HeyPCB/quack-core/cad/fit_section.png

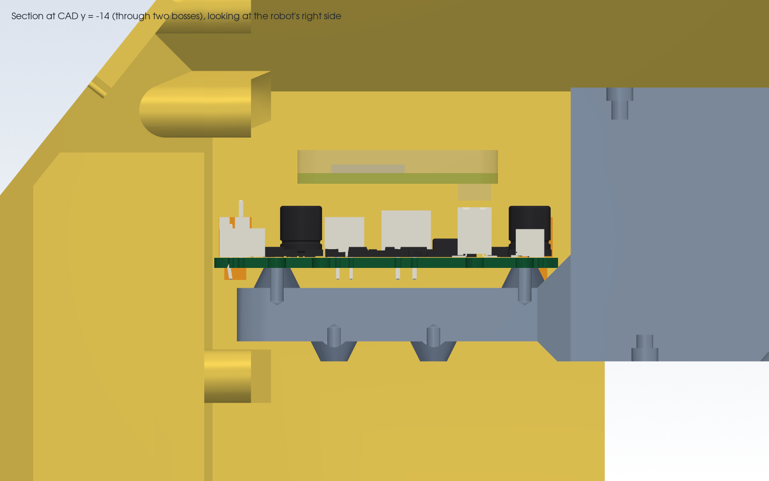
cad/fit_section.png
