HeyPCB/quack-core/cad/fit_top.png

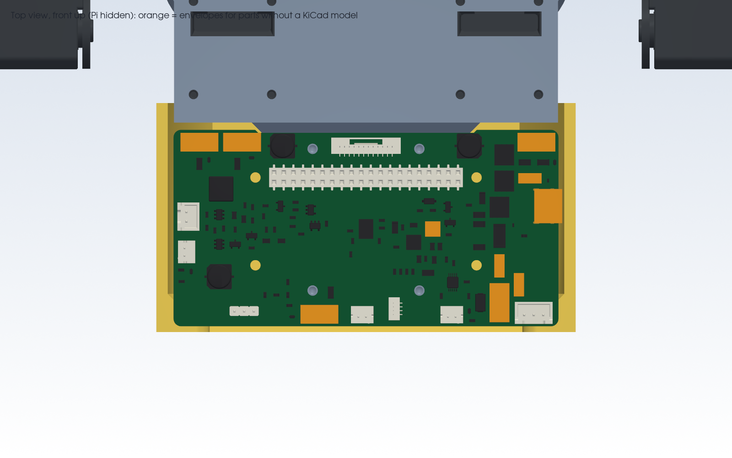
cad/fit_top.png
