HeyPCB/quack-core/cad/fit_usbc.png

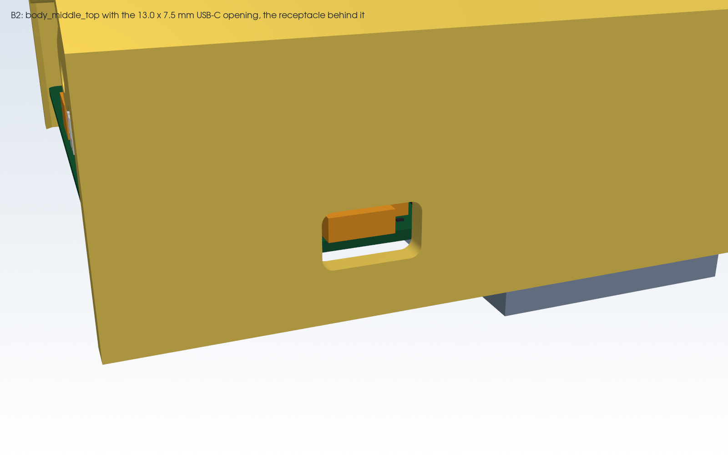
cad/fit_usbc.png
