HeyPCB/quack-core/media/bottom.png

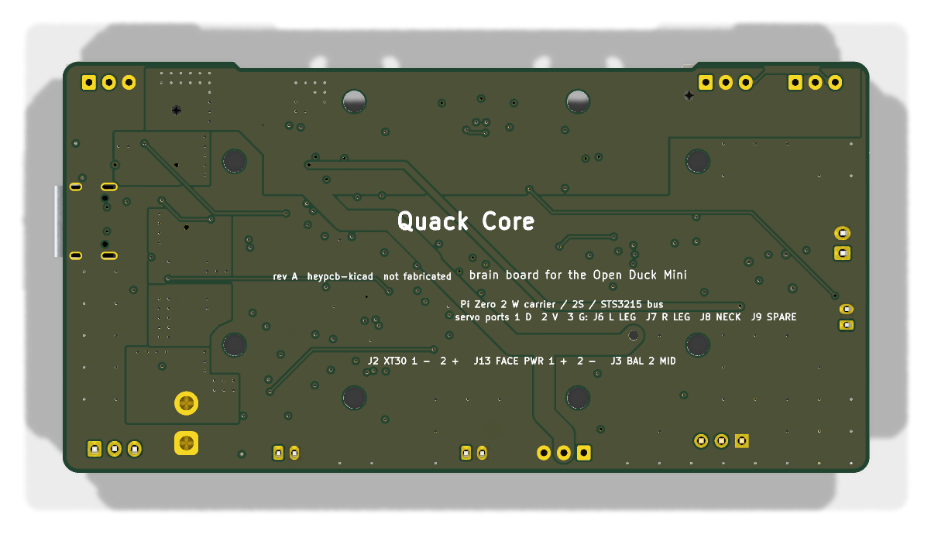
media/bottom.png
