HeyPCB/quack-core/media/top.png

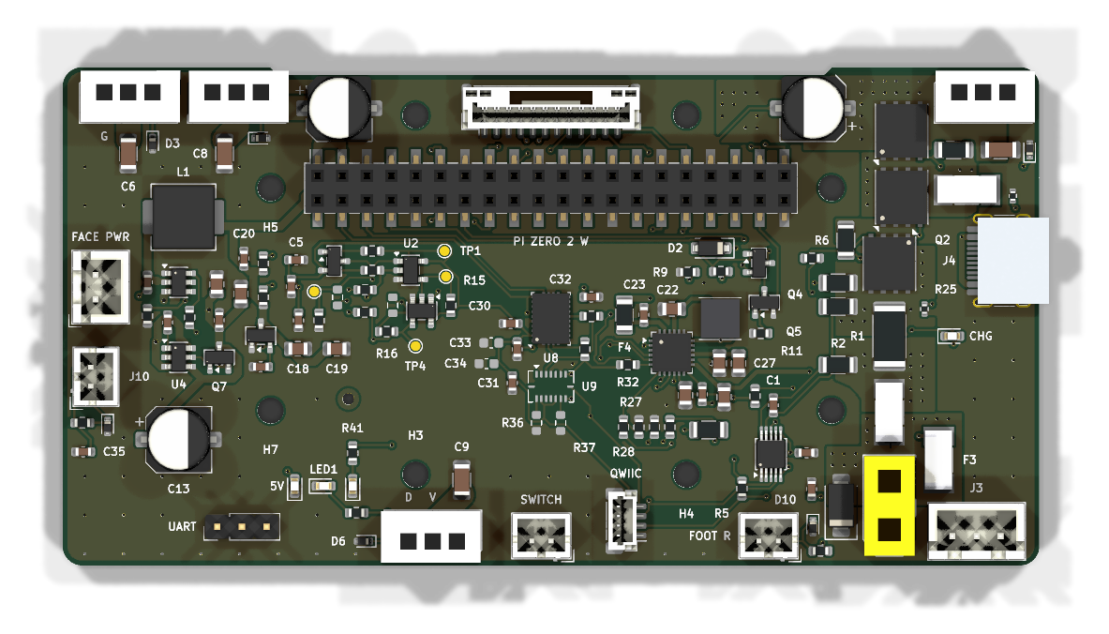
media/top.png
