HeyPCB/quack-core/fab/quack_core_bom.csv

Reference | Value | Footprint | MPN | LCSC | Qty
C1,C2,C3,C4,C12,C16,C17,C29,C30,C35,C36 | 100nF | Capacitor_SMD:C_0603_1608Metric | CC0603KRX7R9BB104 | C14663 | 11
C5,C20,C21,C22,C32 | 1uF | Capacitor_SMD:C_0603_1608Metric | CL10A105KB8NNNC | C15849 | 5
C6,C7,C8,C9 | 10uF | Capacitor_SMD:C_1206_3216Metric | CL31A106KBHNNNE | C13585 | 4
C10,C11,C13 | 470uF 16V | Capacitor_SMD:CP_Elec_6.3x7.7 | RVT1C471M0607 | C2977552 | 3
C14,C15,C28 | 10uF | Capacitor_SMD:C_0805_2012Metric | CL21A106KAYNNNE | C15850 | 3
C18,C19,C23,C26,C27 | 22uF | Capacitor_SMD:C_0805_2012Metric | CL21A226MAQNNNE | C45783 | 5
C24 | 47nF | Capacitor_SMD:C_0603_1608Metric | CL10B473KB8NNNC | C1622 | 1
C25 | 4.7uF | Capacitor_SMD:C_0805_2012Metric | CL21A475KAQNNNE | C1779 | 1
C31 | 22nF | Capacitor_SMD:C_0603_1608Metric | CL10B223KB8NNNC | C21122 | 1
D1 | SMAJ10CA | Diode_SMD:D_SMA | SMAJ10CA | C19077530 | 1
D2 | B5819W | Diode_SMD:D_SOD-123 | B5819W SL | C8598 | 1
D3,D4,D5,D6,D9,D10 | ESD5Z5.0 | Diode_SMD:D_SOD-523 | ESD5Z5.0T1G | C82044 | 6
D7 | Green (5V) | LED_SMD:LED_0603_1608Metric | KT-0603G | C12624 | 1
D8 | Orange (CHG) | LED_SMD:LED_0603_1608Metric | XL-1608UOC-06 | C965800 | 1
D11 | Red (LED1) | LED_SMD:LED_0603_1608Metric | KT-0603R | C2286 | 1
D12 | Red (LED2) | LED_SMD:LED_0603_1608Metric | KT-0603R | C2286 | 1
F1 | 20A | Fuse:Fuse_Littelfuse-NANO2-451_453 | 0451020.MRL | C178980 | 1
F2,F3 | 5A | Fuse:Fuse_Littelfuse-NANO2-451_453 | 0451005.MRL | C48467 | 2
F4 | 2A PTC | Fuse:Fuse_1206_3216Metric | 1206L200/16NR | C22374899 | 1
J1 | Pi Zero 2 W | Connector_PinSocket_2.54mm:PinSocket_2x20_P2.54mm_Vertical_SMD | PM254-2-20-S-8.5 | C3975165 | 1
J2 | XT30 BATT | Connector_AMASS:AMASS_XT30UPB-M_1x02_P5.0mm_Vertical | XT30UPB-M | C428721 | 1
J3 | BALANCE | Connector_JST:JST_XH_B3B-XH-A_1x03_P2.50mm_Vertical | B3B-XH-A(LF)(SN) | C144394 | 1
J4 | USB-C CHARGE | Connector_USB:USB_C_Receptacle_HRO_TYPE-C-31-M-12 | TYPE-C-31-M-12 | C165948 | 1
J5 | SWITCH | Connector_JST:JST_PH_B2B-PH-K_1x02_P2.00mm_Vertical | B2B-PH-K-S(LF)(SN) | C131337 | 1
J6,J7,J8,J9 | SERVO | Connector_Molex:Molex_SPOX_5267-03A_1x03_P2.50mm_Vertical | HC-5264-3A | C2845815 | 4
J10,J11 | FOOT | Connector_JST:JST_PH_B2B-PH-K_1x02_P2.00mm_Vertical | B2B-PH-K-S(LF)(SN) | C131337 | 2
J12 | FACE | Connector_JST:JST_GH_BM12B-GHS-TBT_1x12-1MP_P1.25mm_Vertical | BM12B-GHS-TBT(LF)(SN)(N) | C2983891 | 1
J13 | FACE PWR | Connector_JST:JST_XH_B2B-XH-A_1x02_P2.50mm_Vertical | B2B-XH-A(LF)(SN) | C158012 | 1
J14 | QWIIC | Connector_JST:JST_SH_BM04B-SRSS-TB_1x04-1MP_P1.00mm_Vertical | BM04B-SRSS-TB(LF)(SN) | C160390 | 1
J16 | UART | Connector_PinHeader_2.54mm:PinHeader_1x03_P2.54mm_Vertical | PZ254V-11-03P | C2937625 | 1
L1 | 5.6uH | Inductor_SMD:L_Changjiang_FXL0630 | FXL0630-5R6-M | C475914 | 1
L2 | 1uH | Inductor_SMD:L_Coilcraft_XxL4020 | XFL4020-102MEC | C5355380 | 1
Q1,Q2,Q3 | AON6411 | Package_DFN_QFN:AO_DFN-8-1EP_5.55x5.2mm_P1.27mm_EP4.12x4.6mm | AON6411 | C81007 | 3
Q4,Q5,Q7 | AO3400A | Package_TO_SOT_SMD:SOT-23 | AO3400A | C20917 | 3
Q6 | MMBT3906 | Package_TO_SOT_SMD:SOT-23 | MMBT3906LT1G | C53444 | 1
R1 | 1mΩ 3W | Resistor_SMD:R_2512_6332Metric | HoJLR2512-3W-1mR-1% | C2903470 | 1
R2,R3,R4 | 10 | Resistor_SMD:R_1206_3216Metric | 1206W4F100JT5E | C17903 | 3
R5,R7,R9,R12,R13,R15,R16,R23,R28,R32,R34,R35 | 10k | Resistor_SMD:R_0603_1608Metric | FRC0603F1002TS | C2906982 | 12
R6,R8 | 100k | Resistor_SMD:R_1206_3216Metric | 1206W4F1003T5E | C17900 | 2
R10,R11 | 100k | Resistor_SMD:R_0603_1608Metric | 0603WAF1003T5E | C25803 | 2
R14 | 20k | Resistor_SMD:R_0603_1608Metric | 0603WAF2002T5E | C4184 | 1
R17,R18 | 0 | Resistor_SMD:R_0603_1608Metric | 0603WAF0000T5E | C21189 | 2
R21 | 33 | Resistor_SMD:R_0603_1608Metric | 0603WAF330JT5E | C23140 | 1
R22 | 53.6k | Resistor_SMD:R_0603_1608Metric | FRC0603F5362TS | C2930115 | 1
R24,R33 | 2.2k | Resistor_SMD:R_0603_1608Metric | 0603WAF2201T5E | C4190 | 2
R25,R26 | 5.1k | Resistor_SMD:R_0402_1005Metric | 0402WGF5101TCE | C25905 | 2
R27 | 750 | Resistor_SMD:R_0603_1608Metric | 0603WAF7500T5E | C23241 | 1
R29 | 12.4k | Resistor_SMD:R_0603_1608Metric | FRC0603F1242TS | C2930060 | 1
R30 | 330 | Resistor_SMD:R_0603_1608Metric | 0603WAF3300T5E | C23138 | 1
R31 | 100 | Resistor_SMD:R_1206_3216Metric | 1206W4F1000T5E | C17901 | 1
R38,R39,R40,R41 | 1k | Resistor_SMD:R_0603_1608Metric | 0603WAF1001T5E | C21190 | 4
U1 | INA226 | Package_SO:TSSOP-10_3x3mm_P0.5mm | INA226AIDGSR | C49851 | 1
U2 | 74LVC1G126 | Package_TO_SOT_SMD:SOT-23-5 | SN74LVC1G126DBVR | C7834 | 1
U3 | 74LVC1G125 | Package_TO_SOT_SMD:SOT-23-5 | SN74LVC1G125DBVR | C23654 | 1
U4 | LM74700-Q1 | Package_TO_SOT_SMD:SOT-23-6 | LM74700QDBVRQ1 | C2941042 | 1
U5 | TPS56339 | Package_TO_SOT_SMD:SOT-23-6 | TPS56339DDCR | C2071106 | 1
U6 | XC6206P332 | Package_TO_SOT_SMD:SOT-23-3 | XC6206P332MR-G | C5446 | 1
U7 | BQ25887 | Package_DFN_QFN:Texas_RGE0024H_VQFN-24-1EP_4x4mm_P0.5mm_EP2.7x2.7mm | BQ25887RGER | C2761614 | 1
U8 | BNO055 | Package_LGA:LGA-28_5.2x3.8mm_P0.5mm | BNO055 | C93216 | 1
