HeyPCB/quack-core/cad/body_middle_top_usbc.step

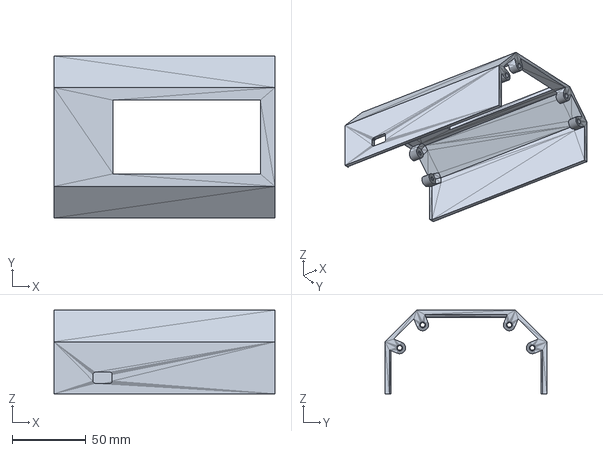
[picture p9: CAD file, 2026-10-03]
cad/body_middle_top_usbc.step
150.0 x 110.0 x 56.8 mm
