HeyPCB/quack-core/fab/quack_core.step

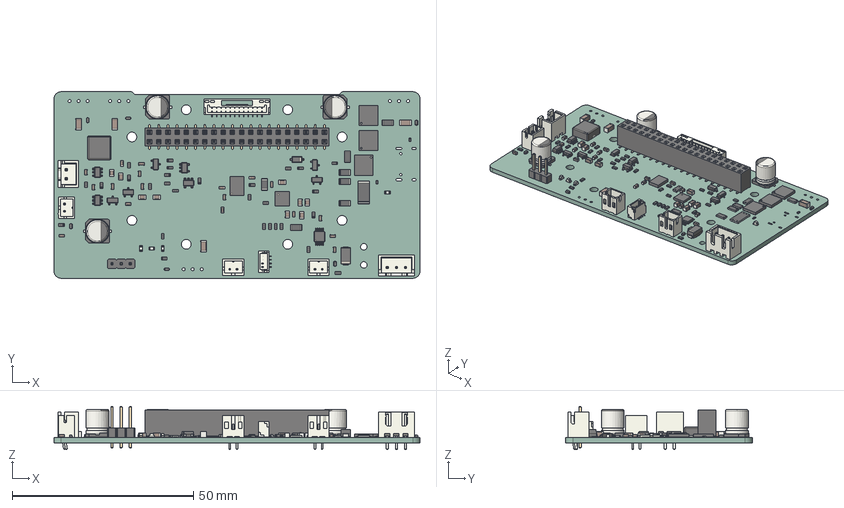
[picture p10: CAD file, 2026-10-03]
fab/quack_core.step
101.0 x 51.5 x 11.9 mm
C_1206_3216Metric x 4
JST_B2B_PH_K x 3
C_0603_1608Metric x 18
R_0603_1608Metric x 28
C_0805_2012Metric x 9
R_1206_3216Metric x 6
SOT-23 x 4
Texas_RGE0024H_VQFN-24-1EP_4x4mm_P0.5mm_EP2.7x2.7mm
LED_0603_1608Metric x 4
JST_BM12B_GHS_TBT
SOT-23-5 x 2
R_0402_1005Metric x 2
D_SOD_523 x 6
SOT-23-6 x 2
TSSOP-10_3x3mm_P0.5mm
Fuse_1206_3216Metric
PinHeader_1x03_P254mm_Vertical
CP_Elec_63x77 x 3
PinSocket_2x20_P2.54mm_Vertical_SMD
SOT-23-3
D_SOD-123
a4dc038a-92ba-11ed-bd60-83025610b399_part x 3
a4dc038b-92ba-11ed-bd60-83025610b399_part x 3
a4dc038c-92ba-11ed-bd60-83025610b399_part x 3
a4dc038d-92ba-11ed-bd60-83025610b399_part x 3
R_2512_6332Metric
JST_SH_BM04B-SRSS-TB_1x04-1MP_P1.00mm_Vertical
JST_B2B_XH_A
LGA_28_52x38mm_P05mm
D_SMA
JST_B3B_XH_A
L_Changjiang_FXL0630
quack_core_PCB
