HeyPCB/quack-core/(list of files, cad)

Other CAD files:
cad/body_middle_top_usbc.stl
