HeyPCB/quack-core/fab/quack_core_schematic.pdf

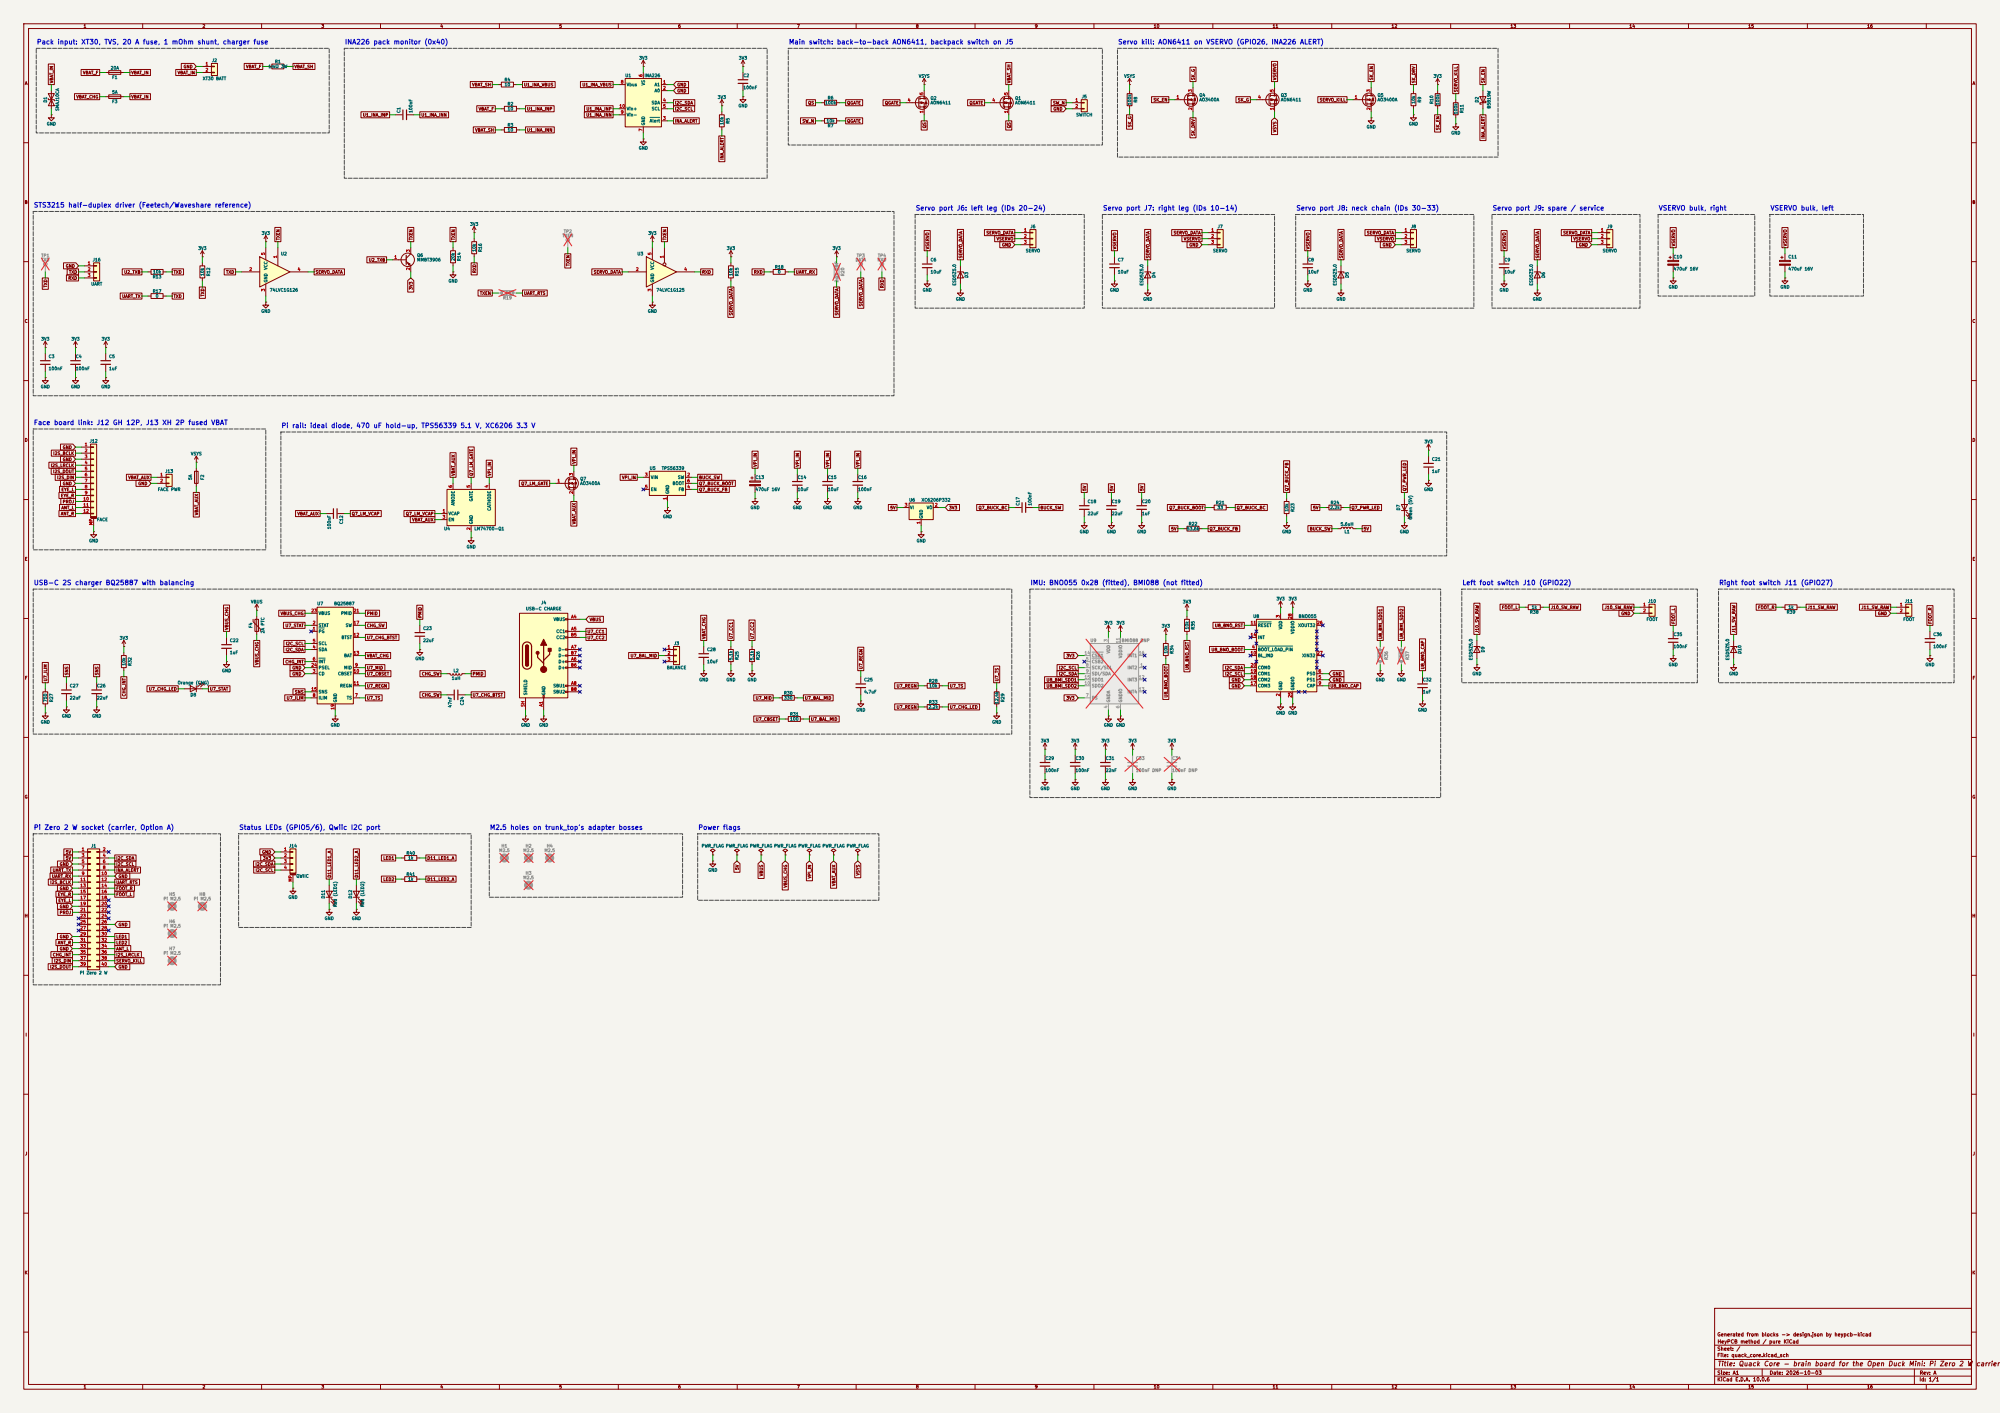
[picture p11: page 1]

Pack input: XT30, TVS, 20 A fuse, 1 mOhm shunt, charger fuse

Main switch: back-to-back AON6411, backpack switch on J5

Servo kill: AON6411 on VSERVO (GPIO26, INA226 ALERT)

STS3215 half-duplex driver (Feetech/Waveshare reference)

Servo port J6: left leg (IDs 20-24)

Servo port J9: spare / service

Face board link: J12 GH 12P, J13 XH 2P fused VBAT

Pi rail: ideal diode, 470 uF hold-up, TPS56339 5.1 V, XC6206 3.3 V

USB-C 2S charger BQ25887 with balancing

Pi Zero 2 W socket (carrier, Option A)
J1 Pi Zero 2 W

Status LEDs (GPIO5/6), Qwiic I2C port

M2.5 holes on trunk_top's adapter bosses

Generated from blocks -> design.json by heypcb-kicad
HeyPCB method / pure KiCad
Sheet: /
File: quack_core.kicad_sch
Title: Quack Core - brain board for the Open Duck Mini: Pi Zero 2 W carrier, 2S power path, STS3215 servo bus

Size: A1 | Rev: A
KiCad E.D.A. 10.0.6 | Id: 1/1
