HeyPCB/quack-core/kicad/quack_core.kicad_pcb

## KiCad design kicad/quack_core.kicad_pcb (2026-10-03)

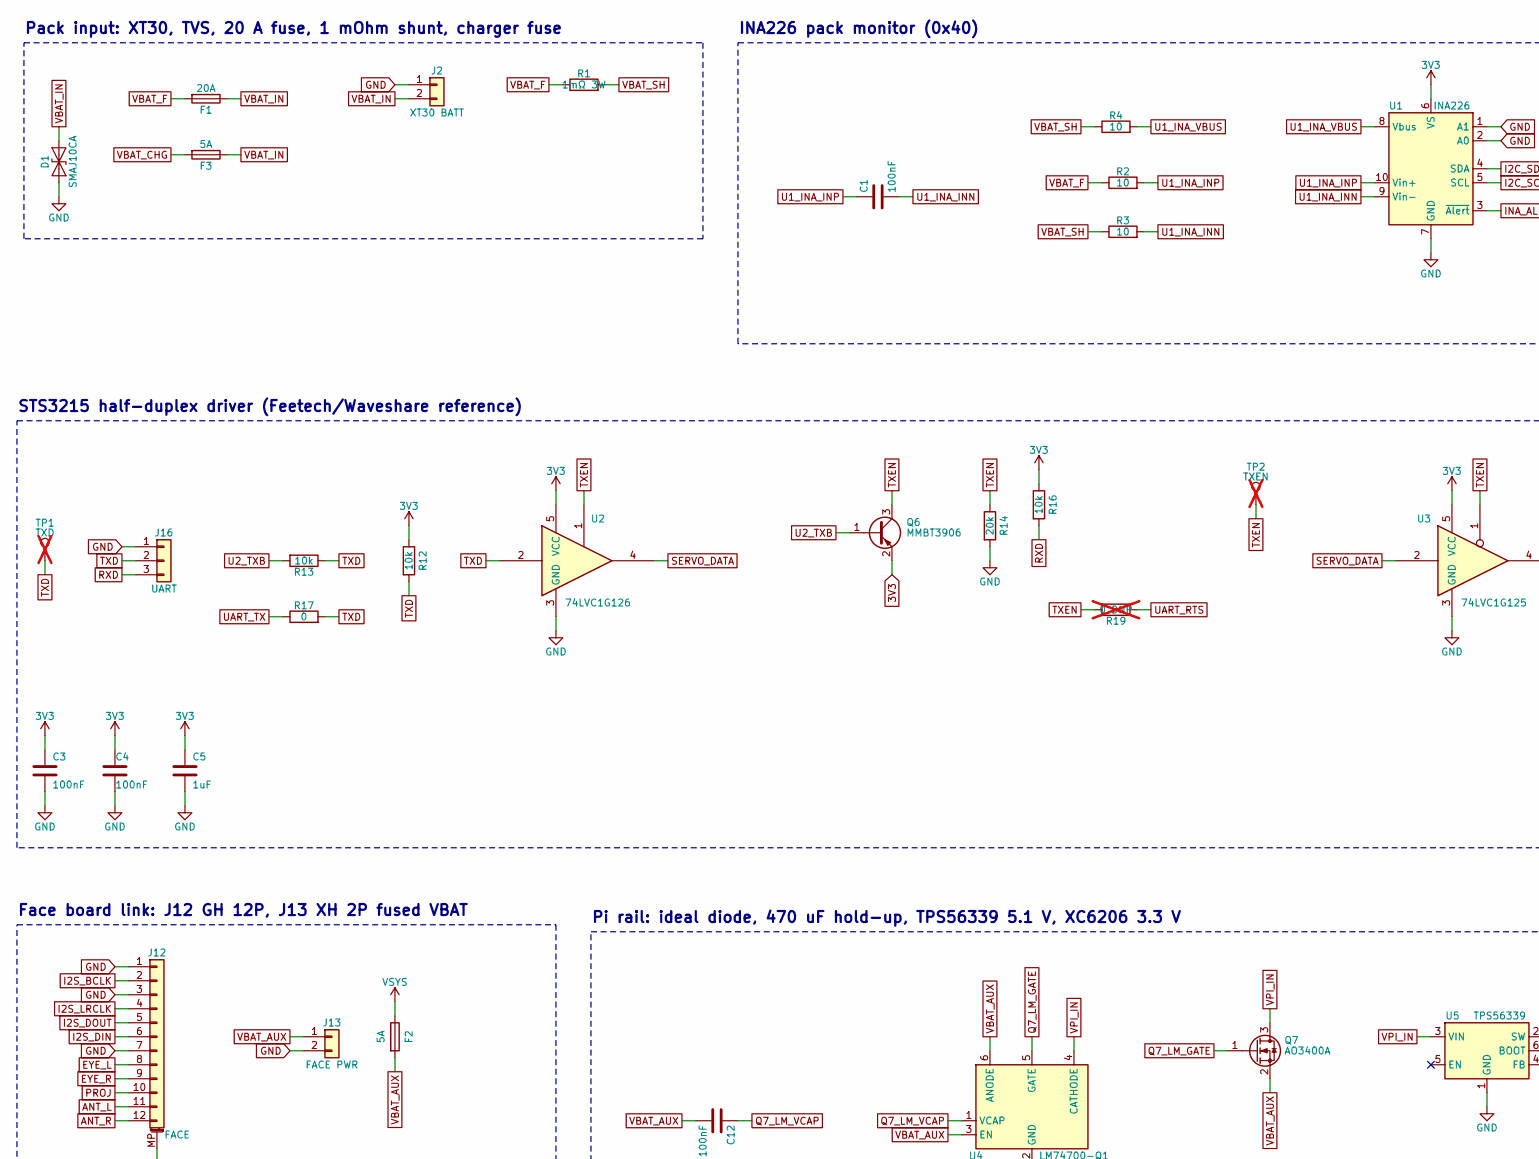
[picture p12: schematic quack_core.kicad_sch, Quack Core - brain board for the Open Duck Mini: Pi Zero 2 …, part in row 1, column 1]

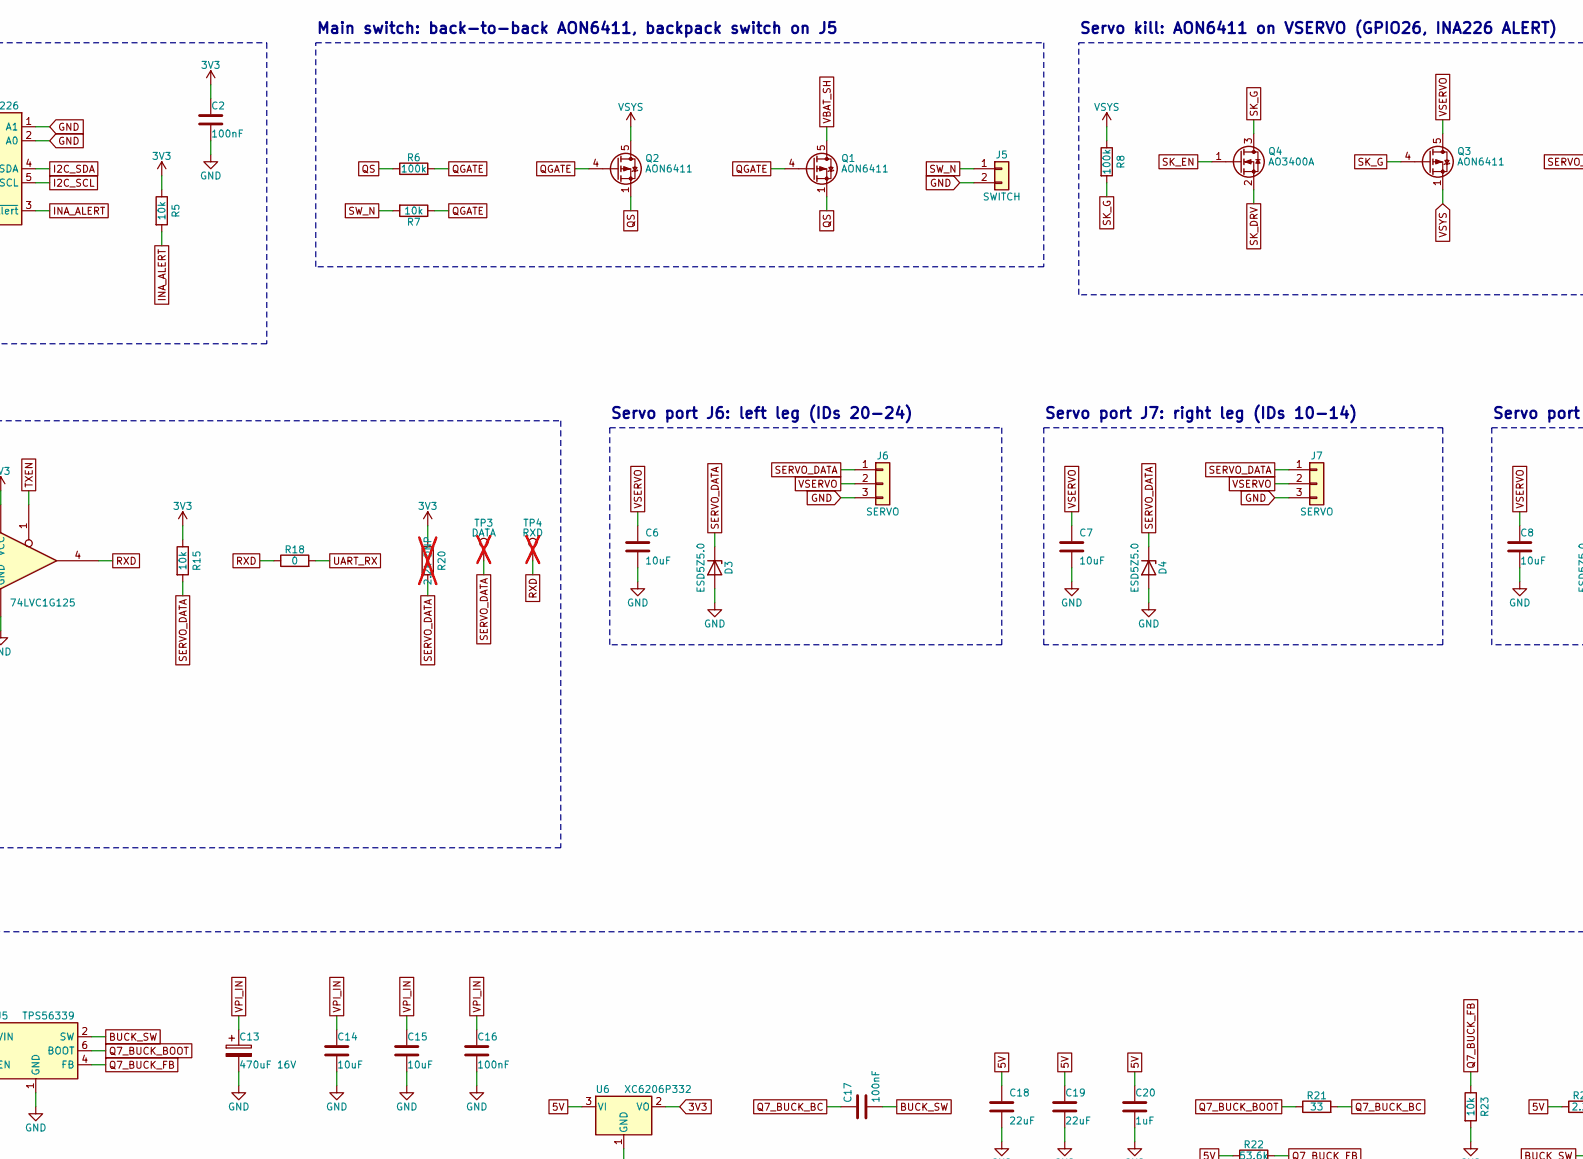
[picture p13: schematic quack_core.kicad_sch, Quack Core - brain board for the Open Duck Mini: Pi Zero 2 …, part in row 1, column 2]

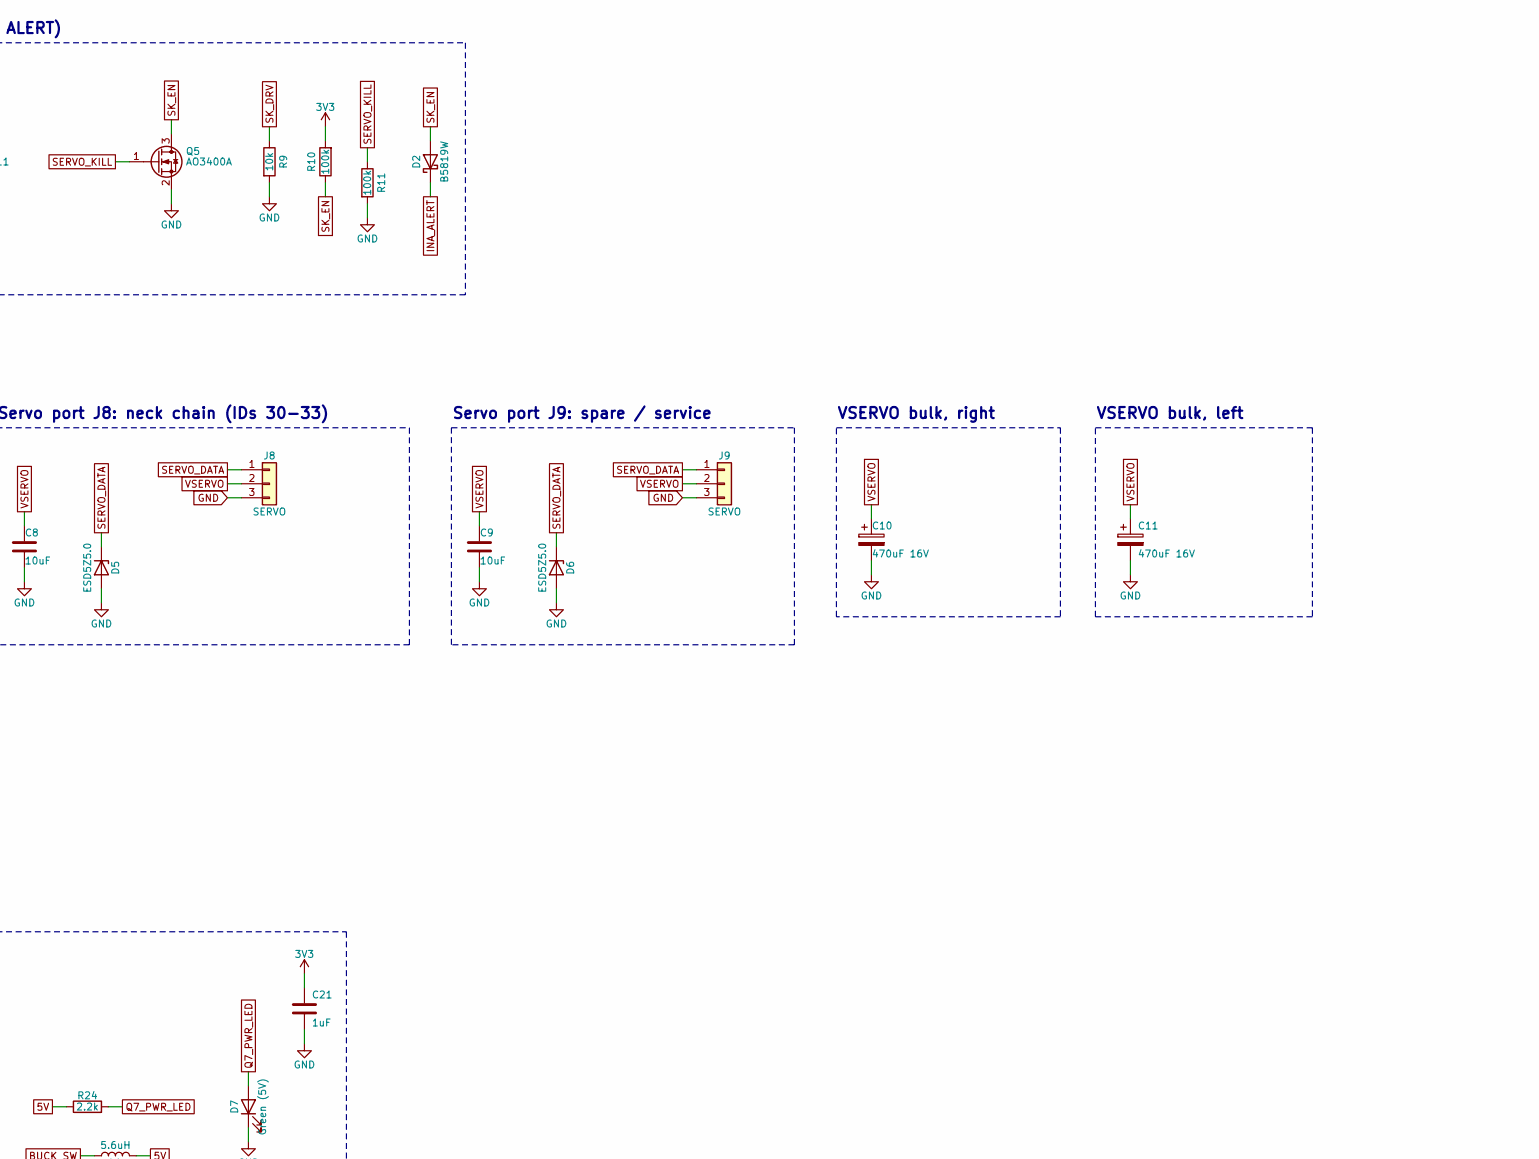
[picture p14: schematic quack_core.kicad_sch, Quack Core - brain board for the Open Duck Mini: Pi Zero 2 …, part in row 1, column 3]

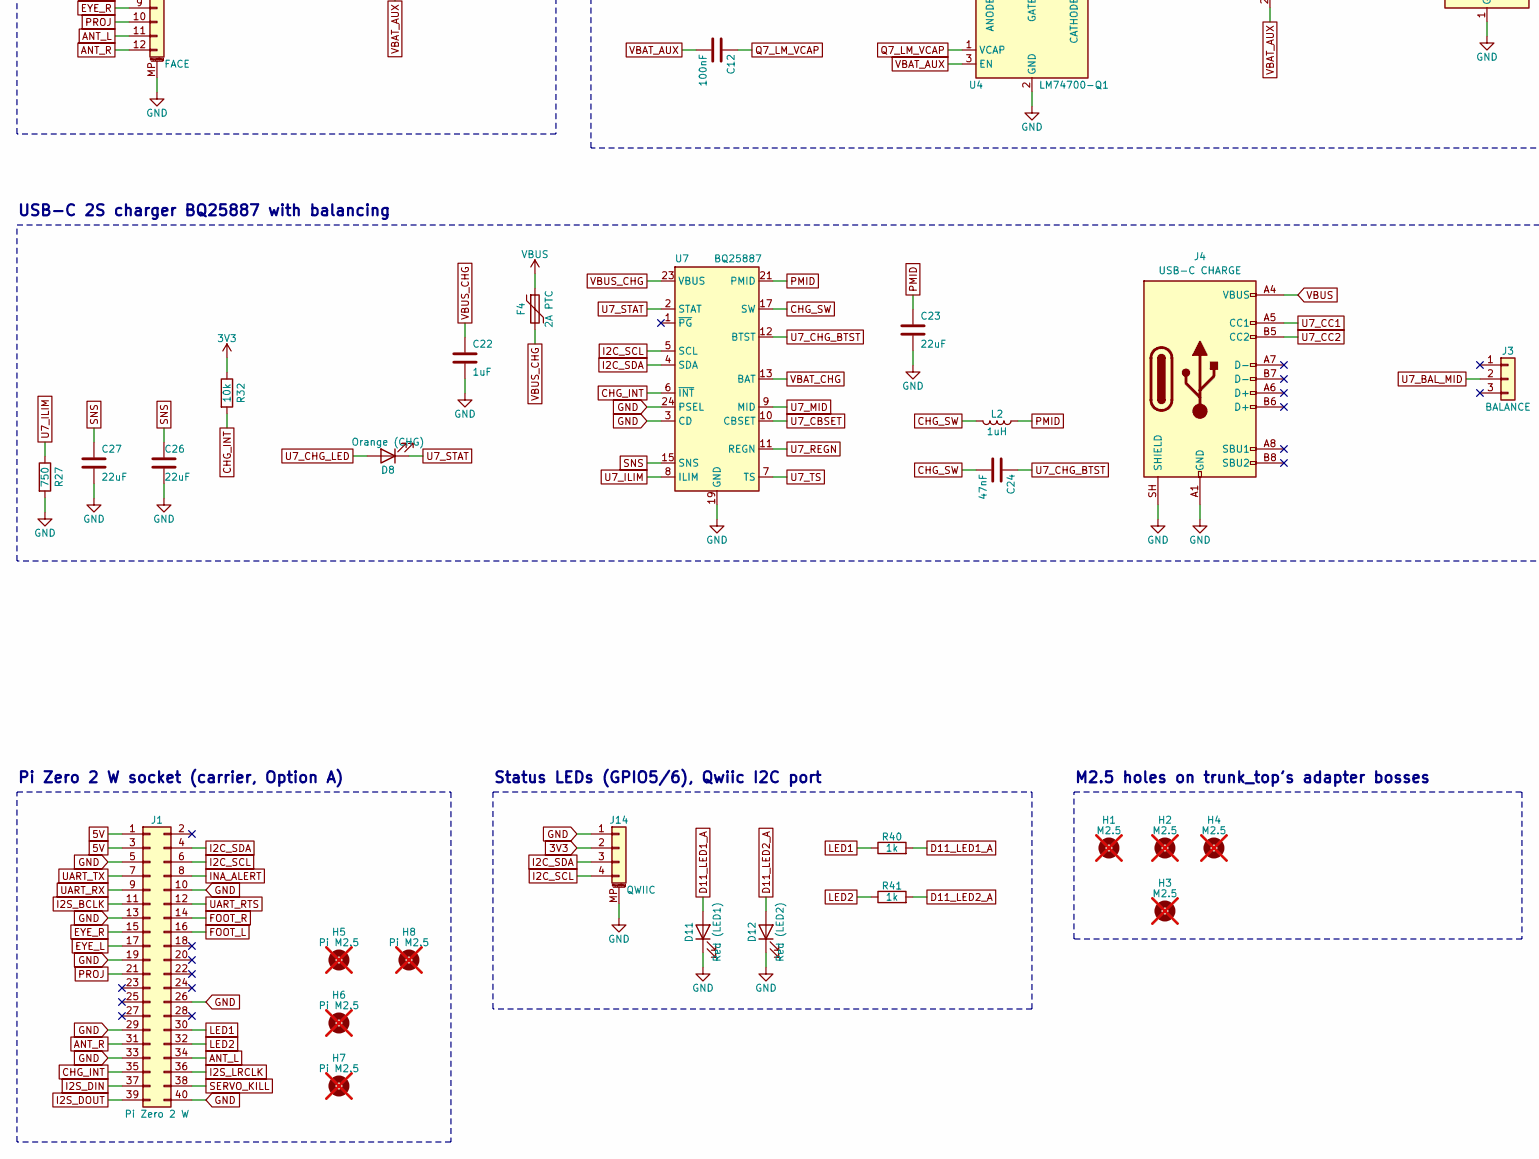
[picture p15: schematic quack_core.kicad_sch, Quack Core - brain board for the Open Duck Mini: Pi Zero 2 …, part in row 2, column 1]

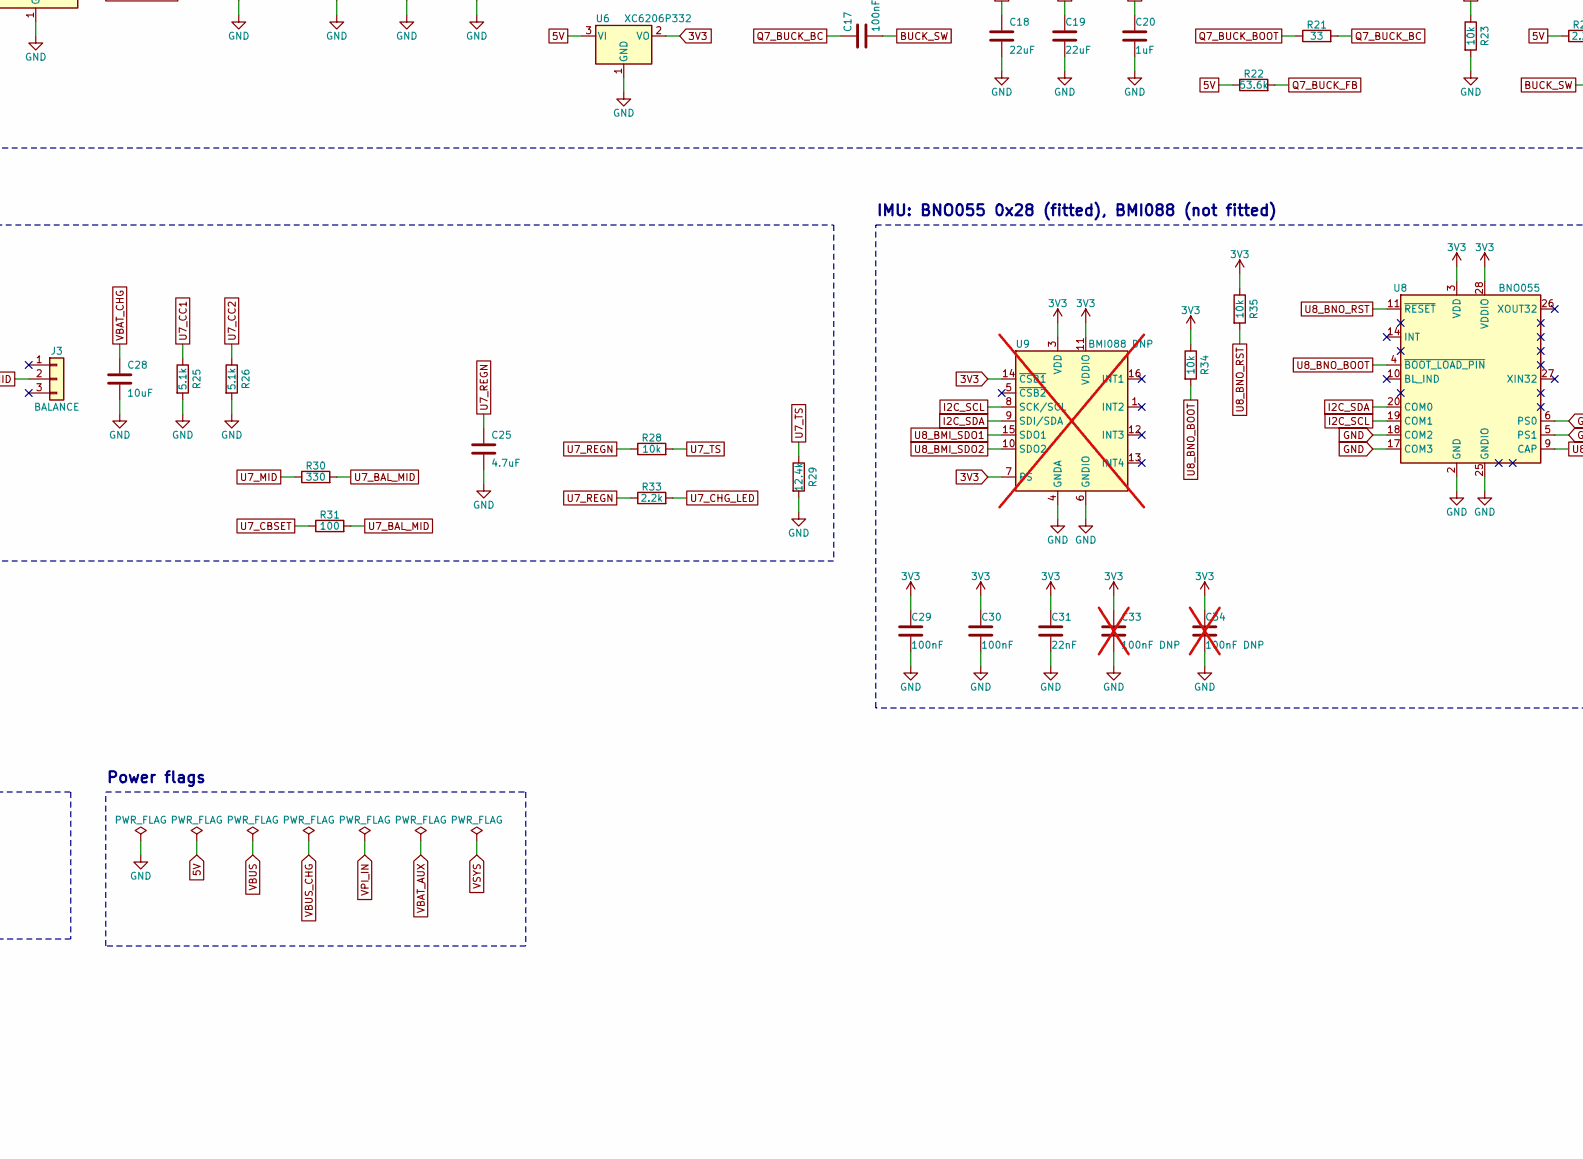
[picture p16: schematic quack_core.kicad_sch, Quack Core - brain board for the Open Duck Mini: Pi Zero 2 …, part in row 2, column 2]

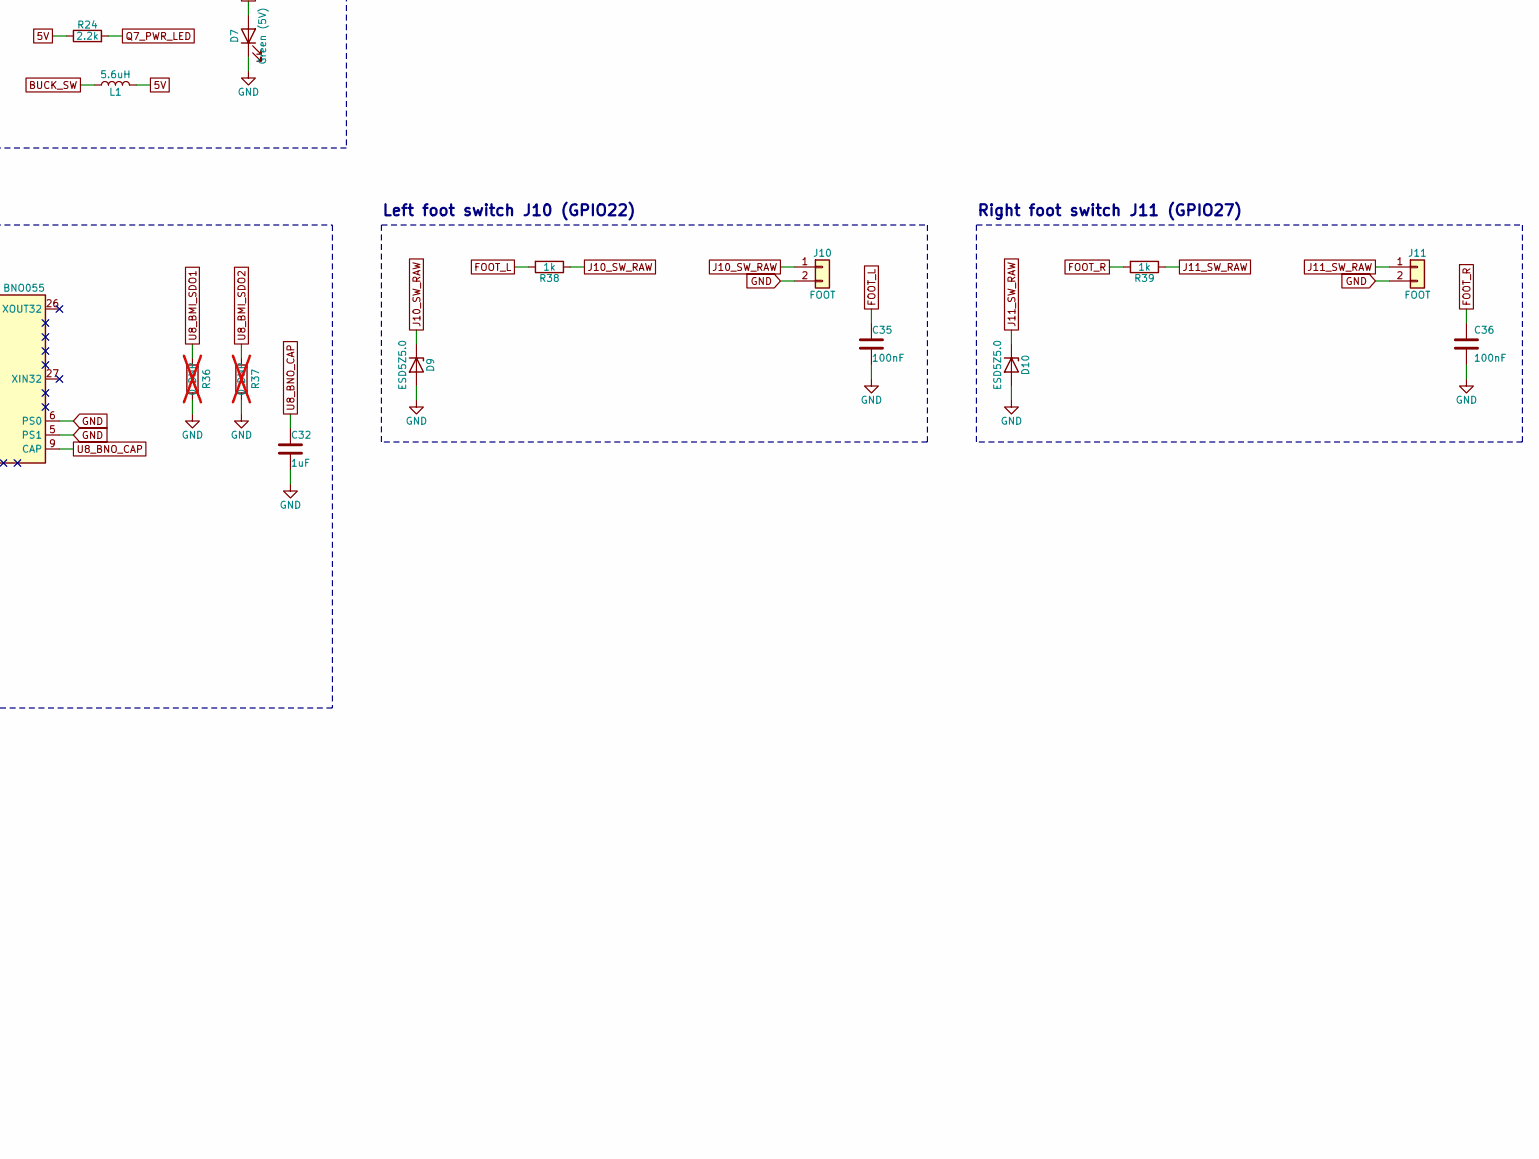
[picture p17: schematic quack_core.kicad_sch, Quack Core - brain board for the Open Duck Mini: Pi Zero 2 …, part in row 2, column 3]

Parts:
C1, C2, C3, C4, C12, C16, C17, C29, C30, C35, C36: 100nF; C_0603_1608Metric; MPN CC0603KRX7R9BB104; LCSC C14663
C5, C20, C21, C22, C32: 1uF; C_0603_1608Metric; MPN CL10A105KB8NNNC; LCSC C15849
C6, C7, C8, C9: 10uF; C_1206_3216Metric; MPN CL31A106KBHNNNE; LCSC C13585
C10, C11, C13: 470uF 16V; CP_Elec_6.3x7.7; MPN RVT1C471M0607; LCSC C2977552
C14, C15, C28: 10uF; C_0805_2012Metric; MPN CL21A106KAYNNNE; LCSC C15850
C18, C19, C23, C26, C27: 22uF; C_0805_2012Metric; MPN CL21A226MAQNNNE; LCSC C45783
C24: 47nF; C_0603_1608Metric; MPN CL10B473KB8NNNC; LCSC C1622
C25: 4.7uF; C_0805_2012Metric; MPN CL21A475KAQNNNE; LCSC C1779
C31: 22nF; C_0603_1608Metric; MPN CL10B223KB8NNNC; LCSC C21122
C33, C34: 100nF DNP; C_0603_1608Metric; not fitted
D1: SMAJ10CA; D_SMA; MPN SMAJ10CA; LCSC C19077530
D2: B5819W; D_SOD-123; MPN B5819W SL; LCSC C8598
D3, D4, D5, D6, D9, D10: ESD5Z5.0; D_SOD-523; MPN ESD5Z5.0T1G; LCSC C82044
D7: Green (5V); LED_0603_1608Metric; MPN KT-0603G; LCSC C12624
D8: Orange (CHG); LED_0603_1608Metric; MPN XL-1608UOC-06; LCSC C965800
D11: Red (LED1); LED_0603_1608Metric; MPN KT-0603R; LCSC C2286
D12: Red (LED2); LED_0603_1608Metric; MPN KT-0603R; LCSC C2286
F1: 20A; Fuse_Littelfuse-NANO2-451_453; MPN 0451020.MRL; LCSC C178980
F2, F3: 5A; Fuse_Littelfuse-NANO2-451_453; MPN 0451005.MRL; LCSC C48467
F4: 2A PTC; Fuse_1206_3216Metric; MPN 1206L200/16NR; LCSC C22374899
H1, H2, H3, H4: M2.5; MountingHole_2.7mm_M2.5; not fitted
H5, H6, H7, H8: Pi M2.5; MountingHole_2.7mm_M2.5; not fitted
J1: Pi Zero 2 W; PinSocket_2x20_P2.54mm_Vertical_SMD; MPN PM254-2-20-S-8.5; LCSC C3975165
J2: XT30 BATT; AMASS_XT30UPB-M_1x02_P5.0mm_Vertical; MPN XT30UPB-M; LCSC C428721
J3: BALANCE; JST_XH_B3B-XH-A_1x03_P2.50mm_Vertical; MPN B3B-XH-A(LF)(SN); LCSC C144394
J4: USB-C CHARGE; USB_C_Receptacle_HRO_TYPE-C-31-M-12; MPN TYPE-C-31-M-12; LCSC C165948
J5: SWITCH; JST_PH_B2B-PH-K_1x02_P2.00mm_Vertical; MPN B2B-PH-K-S(LF)(SN); LCSC C131337
J6, J7, J8, J9: SERVO; Molex_SPOX_5267-03A_1x03_P2.50mm_Vertical; MPN HC-5264-3A; LCSC C2845815
J10, J11: FOOT; JST_PH_B2B-PH-K_1x02_P2.00mm_Vertical; MPN B2B-PH-K-S(LF)(SN); LCSC C131337
J12: FACE; JST_GH_BM12B-GHS-TBT_1x12-1MP_P1.25mm_Vertical; MPN BM12B-GHS-TBT(LF)(SN)(N); LCSC C2983891
J13: FACE PWR; JST_XH_B2B-XH-A_1x02_P2.50mm_Vertical; MPN B2B-XH-A(LF)(SN); LCSC C158012
J14: QWIIC; JST_SH_BM04B-SRSS-TB_1x04-1MP_P1.00mm_Vertical; MPN BM04B-SRSS-TB(LF)(SN); LCSC C160390
J16: UART; PinHeader_1x03_P2.54mm_Vertical; MPN PZ254V-11-03P; LCSC C2937625
L1: 5.6uH; L_Changjiang_FXL0630; MPN FXL0630-5R6-M; LCSC C475914
L2: 1uH; L_Coilcraft_XxL4020; MPN XFL4020-102MEC; LCSC C5355380
Q1, Q2, Q3: AON6411; AO_DFN-8-1EP_5.55x5.2mm_P1.27mm_EP4.12x4.6mm; MPN AON6411; LCSC C81007
Q4, Q5, Q7: AO3400A; SOT-23; MPN AO3400A; LCSC C20917
Q6: MMBT3906; SOT-23; MPN MMBT3906LT1G; LCSC C53444
R1: 1mΩ 3W; R_2512_6332Metric; MPN HoJLR2512-3W-1mR-1%; LCSC C2903470
R2, R3, R4: 10; R_1206_3216Metric; MPN 1206W4F100JT5E; LCSC C17903
R5, R7, R9, R12, R13, R15, R16, R23, R28, R32, R34, R35: 10k; R_0603_1608Metric; MPN FRC0603F1002TS; LCSC C2906982
R6, R8: 100k; R_1206_3216Metric; MPN 1206W4F1003T5E; LCSC C17900
R10, R11: 100k; R_0603_1608Metric; MPN 0603WAF1003T5E; LCSC C25803
R14: 20k; R_0603_1608Metric; MPN 0603WAF2002T5E; LCSC C4184
R17, R18: 0; R_0603_1608Metric; MPN 0603WAF0000T5E; LCSC C21189
R19, R36, R37: 0 DNP; R_0603_1608Metric; not fitted
R20: 2.2k DNP; R_0603_1608Metric; not fitted
R21: 33; R_0603_1608Metric; MPN 0603WAF330JT5E; LCSC C23140
R22: 53.6k; R_0603_1608Metric; MPN FRC0603F5362TS; LCSC C2930115
R24, R33: 2.2k; R_0603_1608Metric; MPN 0603WAF2201T5E; LCSC C4190
R25, R26: 5.1k; R_0402_1005Metric; MPN 0402WGF5101TCE; LCSC C25905
R27: 750; R_0603_1608Metric; MPN 0603WAF7500T5E; LCSC C23241
R29: 12.4k; R_0603_1608Metric; MPN FRC0603F1242TS; LCSC C2930060
R30: 330; R_0603_1608Metric; MPN 0603WAF3300T5E; LCSC C23138
R31: 100; R_1206_3216Metric; MPN 1206W4F1000T5E; LCSC C17901
R38, R39, R40, R41: 1k; R_0603_1608Metric; MPN 0603WAF1001T5E; LCSC C21190
TP1: TXD; TestPoint_Pad_D1.0mm; not fitted
TP2: TXEN; TestPoint_Pad_D1.0mm; not fitted
TP3: DATA; TestPoint_Pad_D1.0mm; not fitted
TP4: RXD; TestPoint_Pad_D1.0mm; not fitted
U1: INA226; TSSOP-10_3x3mm_P0.5mm; MPN INA226AIDGSR; LCSC C49851
U2: 74LVC1G126; SOT-23-5; MPN SN74LVC1G126DBVR; LCSC C7834
U3: 74LVC1G125; SOT-23-5; MPN SN74LVC1G125DBVR; LCSC C23654
U4: LM74700-Q1; SOT-23-6; MPN LM74700QDBVRQ1; LCSC C2941042
U5: TPS56339; SOT-23-6; MPN TPS56339DDCR; LCSC C2071106
U6: XC6206P332; SOT-23-3; MPN XC6206P332MR-G; LCSC C5446
U7: BQ25887; Texas_RGE0024H_VQFN-24-1EP_4x4mm_P0.5mm_EP2.7x2.7mm; MPN BQ25887RGER; LCSC C2761614
U8: BNO055; LGA-28_5.2x3.8mm_P0.5mm; MPN BNO055; LCSC C93216
U9: BMI088 DNP; Bosch_LGA-16_4.5x3mm_P0.5mm_LayoutBorder7x1y_ClockwisePinNu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; MPN BMI088; LCSC C194919; not fitted

Connections:
3V3: C2.1, C3.1, C4.1, C5.1, C21.1, C29.1, C30.1, C31.1, C33.1, C34.1, J14.2, Q6.2 (E), R5.1, R10.2, R12.1, R15.1, R16.1, R20.1, R32.1, R34.1, R35.1, U1.6 (VS), U2.5 (VCC), U3.5 (VCC), U6.2 (VO), U8.3 (VDD), U8.28 (VDDIO), U9.3 (VDD), U9.7 (PS), U9.11 (VDDIO), U9.14 (~CSB1)
5V: C18.1, C19.1, C20.1, J1.1, J1.3, L1.2, R22.1, R24.1, U6.3 (VI)
ANT_L: J1.34, J12.11
ANT_R: J1.31, J12.12
BUCK_SW: C17.2, L1.1, U5.2 (SW)
CHG_INT: J1.35, R32.2, U7.6 (~INT)
CHG_SW: C24.2, L2.2, U7.17 (SW), U7.18 (SW)
D11_LED1_A: D11.2 (A), R40.2
D11_LED2_A: D12.2 (A), R41.2
EYE_L: J1.17, J12.8
EYE_R: J1.15, J12.9
FOOT_L: C35.1, J1.16, R38.2
FOOT_R: C36.1, J1.14, R39.2
GND: C2.2, C3.2, C4.2, C5.2, C6.2, C7.2, C8.2, C9.2, C10.2, C11.2, C13.2, C14.2, C15.2, C16.2, C18.2, C19.2, C20.2, C21.2, C22.2, C23.2, C25.2, C26.2, C27.2, C28.2, C29.2, C30.2, C31.2, C32.2, C33.2, C34.2, C35.2, C36.2, D1.1 (A1), D3.2 (A), D4.2 (A), D5.2 (A), D6.2 (A), D7.1 (K), D9.2 (A), D10.2 (A), D11.1 (K), D12.1 (K), J1.5, J1.10, J1.13, J1.19, J1.26, J1.29, J1.33, J1.40, J2.1, J4.A1 (GND), J4.A12 (GND), J4.B1 (GND), J4.B12 (GND), J4.SH (SHIELD), J5.2, J6.3, J7.3, J8.3, J9.3, J10.2, J11.2, J12.1, J12.3, J12.7, J12.MP (MountPin), J13.2, J14.1, J14.MP (MountPin), J16.1, Q5.2 (S), R9.2, R11.2, R14.2, R23.2, R25.2, R26.2, R27.2, R29.2, R36.2, R37.2, U1.1 (A1), U1.2 (A0), U1.7 (GND), U2.3 (GND), U3.3 (GND), U4.2 (GND), U5.1 (GND), U6.1 (GND), U7.3 (CD), U7.19 (GND), U7.20 (GND), U7.24 (PSEL), U7.25 (GND), U8.2 (GND), U8.5 (PS1), U8.6 (PS0), U8.17 (COM3), U8.18 (COM2), U8.25 (GNDIO), U9.2 (GNDA), U9.4 (GNDA), U9.6 (GNDIO)
I2C_SCL: J1.6, J14.4, U1.5 (SCL), U7.5 (SCL), U8.19 (COM1), U9.8 (SCK/SCL)
I2C_SDA: J1.4, J14.3, U1.4 (SDA), U7.4 (SDA), U8.20 (COM0), U9.9 (SDI/SDA)
I2S_BCLK: J1.11, J12.2
I2S_DIN: J1.37, J12.6
I2S_DOUT: J1.39, J12.5
I2S_LRCLK: J1.36, J12.4
INA_ALERT: D2.1 (K), J1.8, R5.2, U1.3 (~Alert)
J10_SW_RAW: D9.1 (K), J10.1, R38.1
J11_SW_RAW: D10.1 (K), J11.1, R39.1
LED1: J1.30, R40.1
LED2: J1.32, R41.1
PMID: C23.1, L2.1, U7.21 (PMID), U7.22 (PMID)
PROJ: J1.21, J12.10
Q7_BUCK_BC: C17.1, R21.2
Q7_BUCK_BOOT: R21.1, U5.6 (BOOT)
Q7_BUCK_FB: R22.2, R23.1, U5.4 (FB)
Q7_LM_GATE: Q7.1 (G), U4.5 (GATE)
Q7_LM_VCAP: C12.1, U4.1 (VCAP)
Q7_PWR_LED: D7.2 (A), R24.2
QGATE: Q1.4 (G), Q2.4 (G), R6.2, R7.1
QS: Q1.1 (S), Q1.2 (S), Q1.3 (S), Q2.1 (S), Q2.2 (S), Q2.3 (S), R6.1
RXD: J16.3, R16.2, R18.1, TP4.1, U3.4
SERVO_DATA: D3.1 (K), D4.1 (K), D5.1 (K), D6.1 (K), J6.1, J7.1, J8.1, J9.1, R15.2, R20.2, TP3.1, U2.4, U3.2
SERVO_KILL: J1.38, Q5.1 (G), R11.1
SK_DRV: Q4.2 (S), R9.1
SK_EN: D2.2 (A), Q4.1 (G), Q5.3 (D), R10.1
SK_G: Q3.4 (G), Q4.3 (D), R8.2
SNS: C26.1, C27.1, U7.15 (SNS), U7.16 (SNS)
SW_N: J5.1, R7.2
TXD: J16.2, R12.2, R13.1, R17.2, TP1.1, U2.2
TXEN: Q6.3 (C), R14.1, R19.2, TP2.1, U2.1, U3.1
U1_INA_INN: C1.2, R3.2, U1.9 (Vin-)
U1_INA_INP: C1.1, R2.2, U1.10 (Vin+)
U1_INA_VBUS: R4.2, U1.8 (Vbus)
U2_TXB: Q6.1 (B), R13.2
U7_BAL_MID: J3.2, R30.2, R31.2
U7_CBSET: R31.1, U7.10 (CBSET)
U7_CC1: J4.A5 (CC1), R25.1
U7_CC2: J4.B5 (CC2), R26.1
U7_CHG_BTST: C24.1, U7.12 (BTST)
U7_CHG_LED: D8.2 (A), R33.2
U7_ILIM: R27.1, U7.8 (ILIM)
U7_MID: R30.1, U7.9 (MID)
U7_REGN: C25.1, R28.1, R33.1, U7.11 (REGN)
U7_STAT: D8.1 (K), U7.2 (STAT)
U7_TS: R28.2, R29.1, U7.7 (TS)
U8_BMI_SDO1: R36.1, U9.15 (SDO1)
U8_BMI_SDO2: R37.1, U9.10 (SDO2)
U8_BNO_BOOT: R34.2, U8.4 (~BOOT_LOAD_PIN)
U8_BNO_CAP: C32.1, U8.9 (CAP)
U8_BNO_RST: R35.2, U8.11 (~RESET)
UART_RTS: J1.12, R19.1
UART_RX: J1.9, R18.2
UART_TX: J1.7, R17.1
VBAT_AUX: C12.2, F2.2, J13.1, Q7.2 (S), U4.3 (EN), U4.6 (ANODE)
VBAT_CHG: C28.1, F3.2, U7.13 (BAT), U7.14 (BAT)
VBAT_F: F1.2, R1.1, R2.1
VBAT_IN: D1.2 (A2), F1.1, F3.1, J2.2
VBAT_SH: Q1.5 (D), R1.2, R3.1, R4.1
VBUS: F4.1, J4.A4 (VBUS), J4.A9 (VBUS), J4.B4 (VBUS), J4.B9 (VBUS)
VBUS_CHG: C22.1, F4.2, U7.23 (VBUS)
VPI_IN: C13.1, C14.1, C15.1, C16.1, Q7.3 (D), U4.4 (CATHODE), U5.3 (VIN)
VSERVO: C6.1, C7.1, C8.1, C9.1, C10.1, C11.1, J6.2, J7.2, J8.2, J9.2, Q3.5 (D)
VSYS: F2.1, Q2.5 (D), Q3.1 (S), Q3.2 (S), Q3.3 (S), R8.1

Notes on the sheet:
Pack input: XT30, TVS, 20 A fuse, 1 mOhm shunt, charger fuse
INA226 pack monitor (0x40)
Main switch: back-to-back AON6411, backpack switch on J5
Servo kill: AON6411 on VSERVO (GPIO26, INA226 ALERT)
STS3215 half-duplex driver (Feetech/Waveshare reference)
Servo port J6: left leg (IDs 20-24)
Servo port J7: right leg (IDs 10-14)
Servo port J8: neck chain (IDs 30-33)
Servo port J9: spare / service
VSERVO bulk, right
VSERVO bulk, left
Face board link: J12 GH 12P, J13 XH 2P fused VBAT
Pi rail: ideal diode, 470 uF hold-up, TPS56339 5.1 V, XC6206 3.3 V
USB-C 2S charger BQ25887 with balancing
IMU: BNO055 0x28 (fitted), BMI088 (not fitted)
Left foot switch J10 (GPIO22)
Right foot switch J11 (GPIO27)
Pi Zero 2 W socket (carrier, Option A)
Status LEDs (GPIO5/6), Qwiic I2C port
M2.5 holes on trunk_top's adapter bosses
Power flags

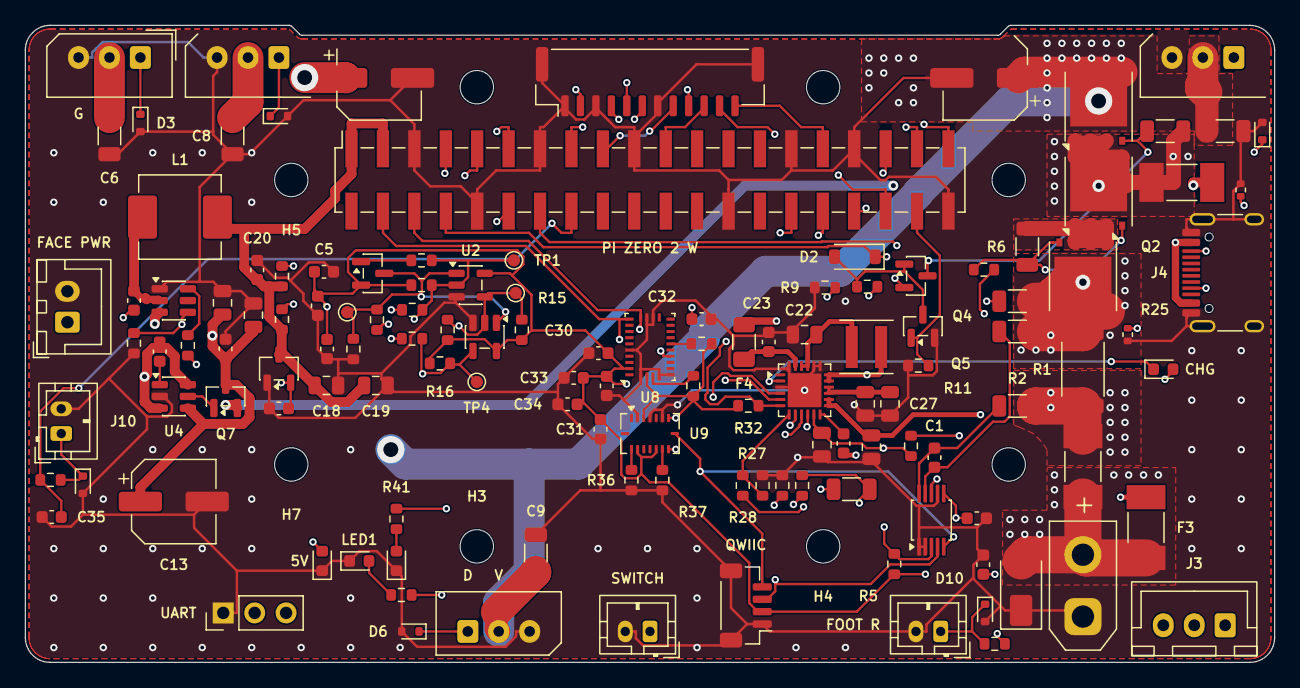
[picture p18: board quack_core.kicad_pcb from above]

Board: 4 copper layers, 101.0 x 51.5 mm, 138 parts (0 on the bottom side), 78 nets.
